bilan93-code/Space-octopus/downloads/Motor_Gmsh_Elmer_Candidate_mm.step

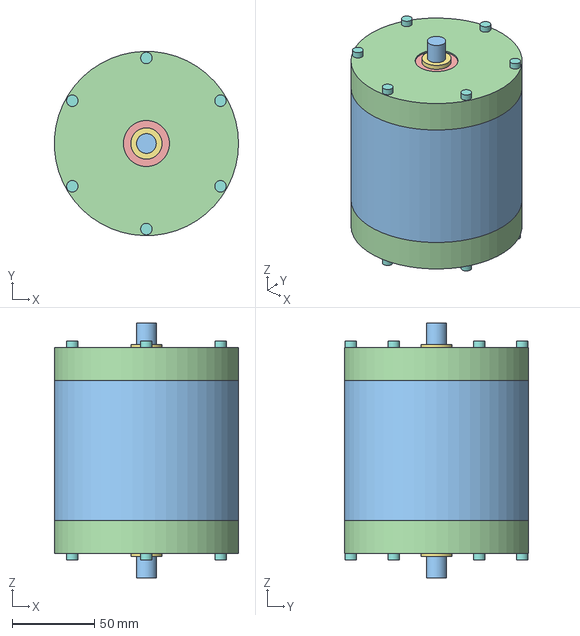
[picture p16: CAD file, 2026-11-06]
downloads/Motor_Gmsh_Elmer_Candidate_mm.step
111.9 x 111.9 x 155.0 mm
