bilan93-code/Space-octopus/downloads/SpaceOctopusMotorActive.step

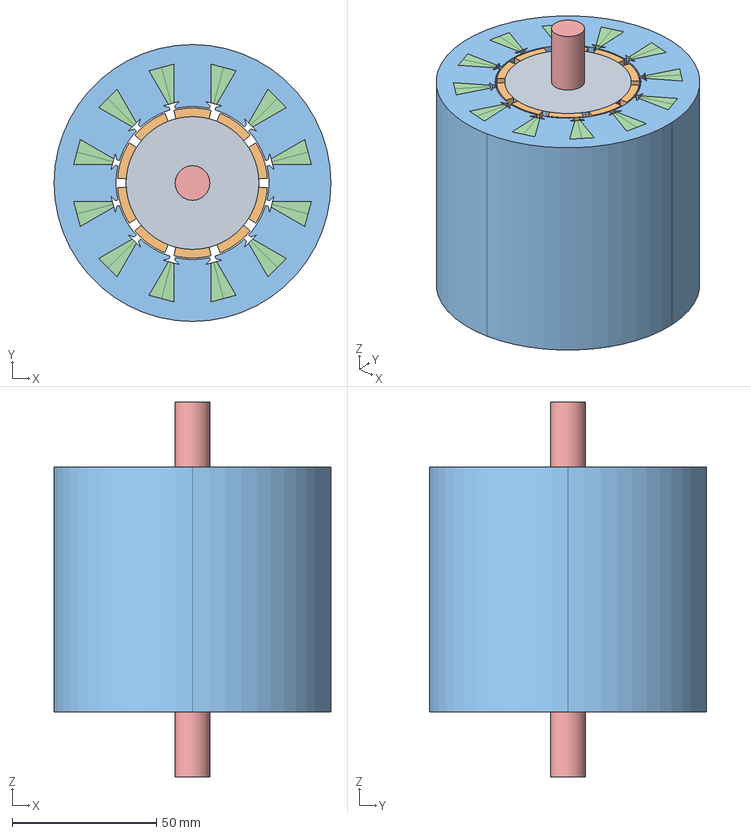
[picture p17: CAD file, 2026-11-06]
downloads/SpaceOctopusMotorActive.step
96.0 x 96.0 x 130.0 mm
