bilan93-code/Space-octopus/(list of files, cad)

Other CAD files:
downloads/SpaceOctopusMotorActive.FCStd
