bilan93-code/Space-octopus/(commit log)

2026-11-06 Add motor CAD and study download packages
    [SpaceOctopusMotorActive.FCStd, SpaceOctopusMotorActive.step]
2026-11-06 Add standalone detailed motor dimensions and analysis PDF
2026-11-06 Add executed Gmsh Elmer motor study, CAD and validation models
    [Motor_Gmsh_Elmer_Candidate_mm.step, Motor_Gmsh_Elmer_download_manifest.json]
